algofoogle/tt03p5-solo-squash/doc/verilator.png

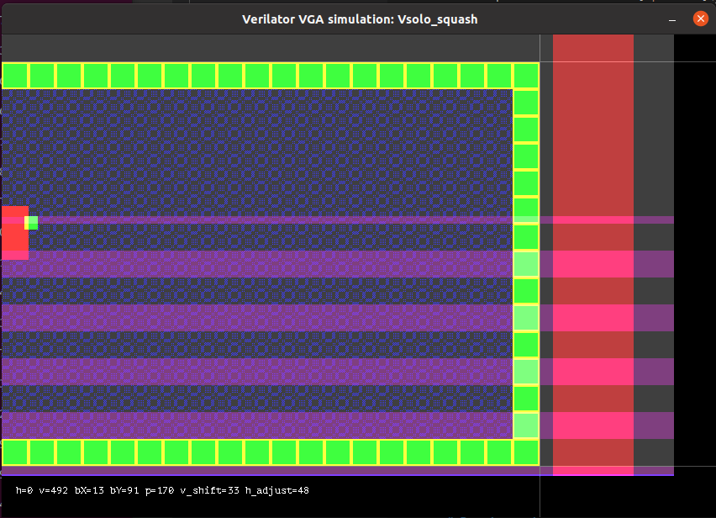
doc/verilator.png
