algofoogle/tt03p5-solo-squash/test/README.md

# Testing tt03p5-solo-squash

For more information on tests, see: [`testing.md`](../doc/testing.md)
