algofoogle/tt03p5-solo-squash/(commit log)

2023-06-01 Oops, minor Verilog error
    [top.v]
2023-06-01 Trying to fix weird Yosys 1'x error
    [top.v]
2023-06-01 Use solo_squash without power pins
2023-06-02 Some corrections to top interface
    [top.v]
2023-06-02 Registered RGB outputs, metastability avoidance on inputs
    [top.v]
2023-06-02 Basic first lines and first frame test now works adequately
2023-06-02 Extra input signal switches between extra debug outputs
2024-01-28 Basic frame tests should work with TT's upython lib now
2024-01-29 Major rework of test.py and testing doco update
    [test.py]
2024-02-05 Rewrite test instructions a bit. Include hookup schematic
2024-02-05 Fix some bugs in the tt-demo-board test
    [test.py]
